GiovanniPacella/PONG_Arcade/images/pong1.jpeg

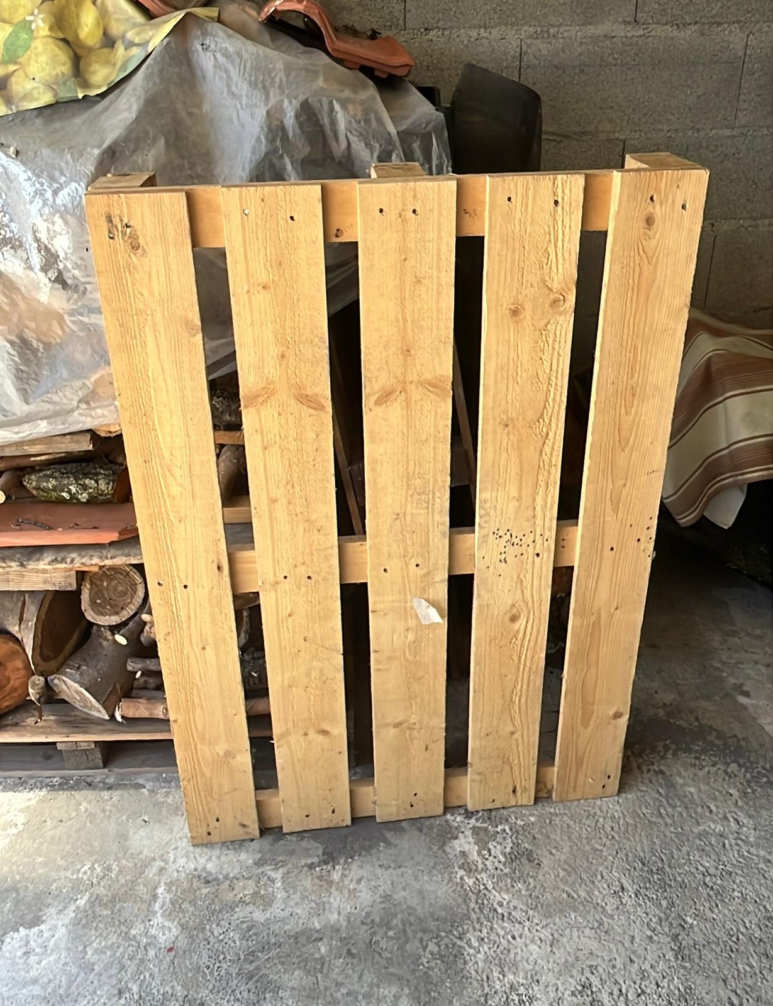
images/pong1.jpeg
