GiovanniPacella/PONG_Arcade/images/pong2.jpeg

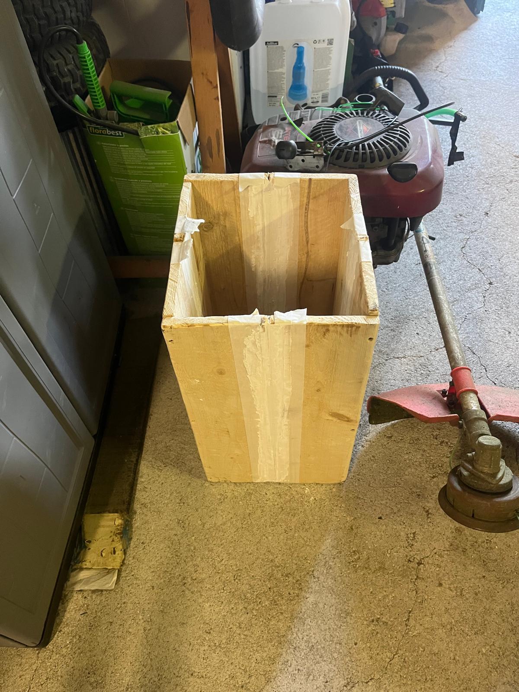
images/pong2.jpeg
