GiovanniPacella/PONG_Arcade/images/pong3.jpeg

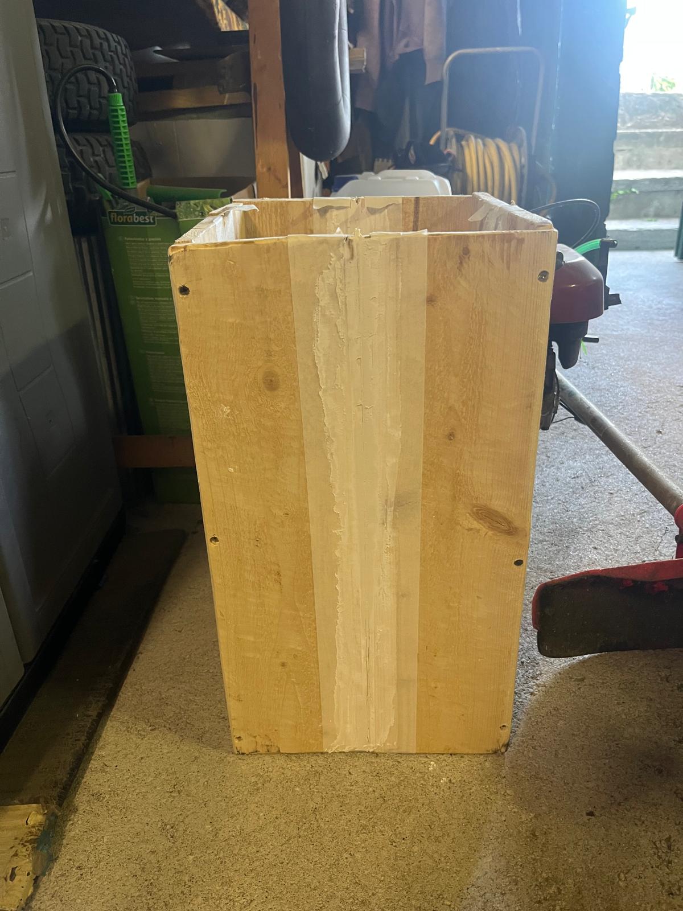
images/pong3.jpeg
