GiovanniPacella/PONG_Arcade/images/pong4.jpeg

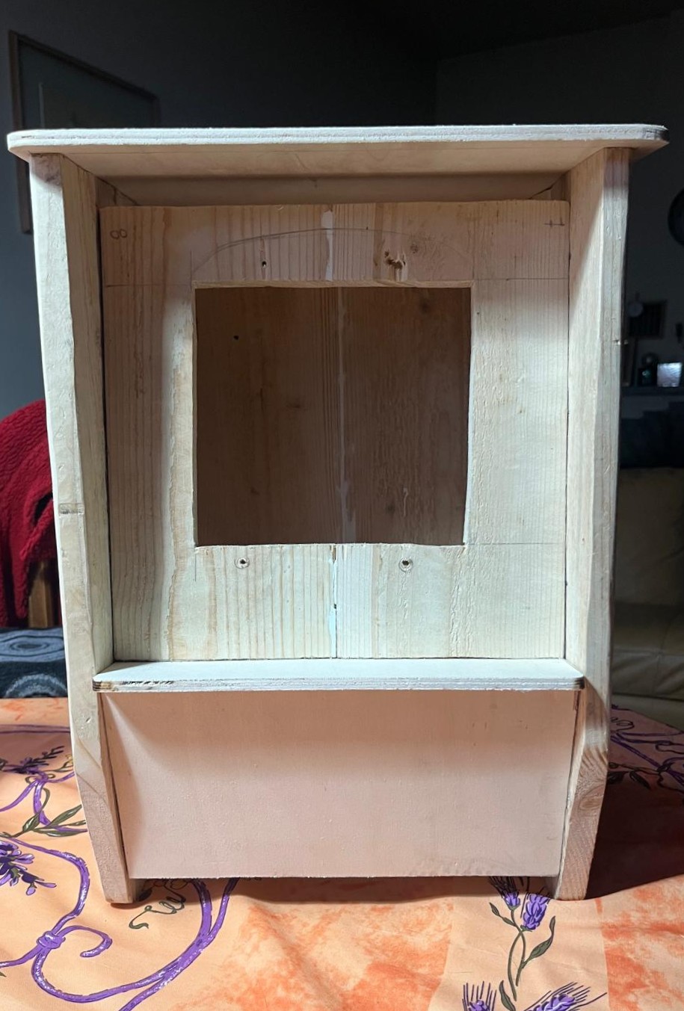
images/pong4.jpeg
