GiovanniPacella/PONG_Arcade/images/pong5.jpeg

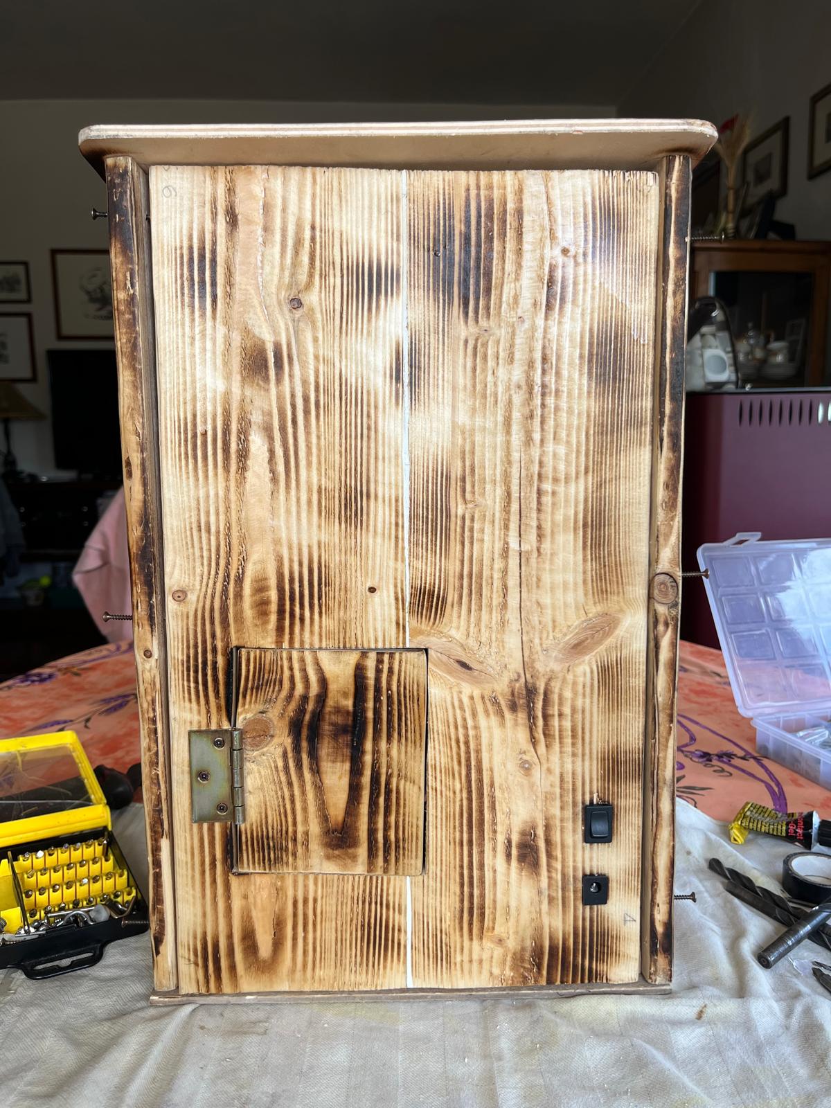
images/pong5.jpeg
