GiovanniPacella/PONG_Arcade/images/pong6.jpeg

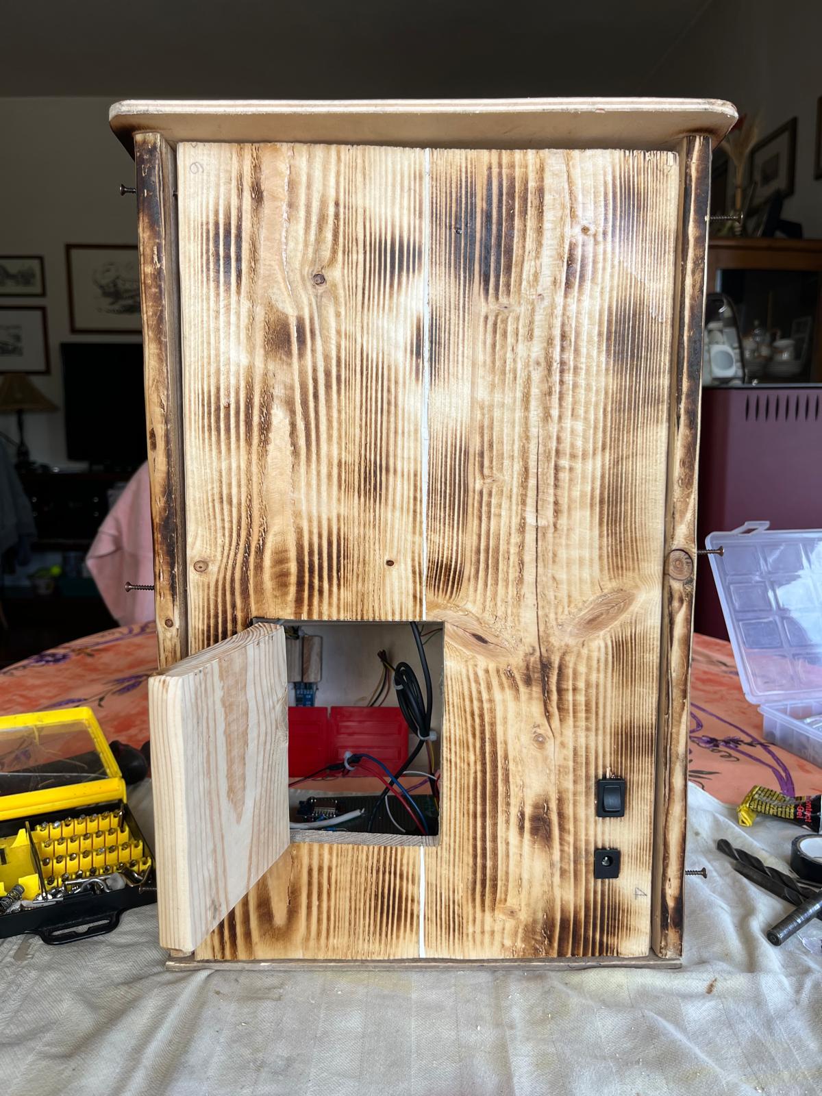
images/pong6.jpeg
