GiovanniPacella/PONG_Arcade/images/pong7.jpeg

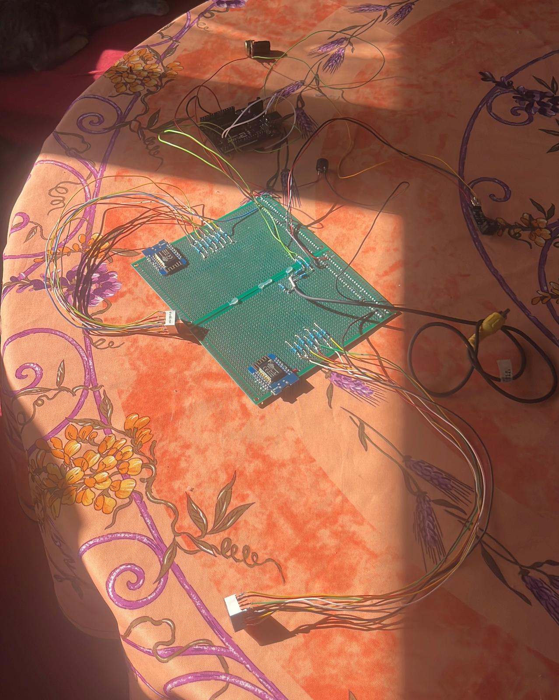
images/pong7.jpeg
