GiovanniPacella/PONG_Arcade/firmware/Comandi.h

#ifndef COMANDI_H
#define COMANDI_H

// Definizioni Comandi Seriale (UART)
#define POINT_P1 81
#define POINT_P2 82
#define RESET 84
#define POWER_OFF 85

// Limiti racchette - Player 1 & Player 2
#define MIN_PADDLE_P1 0
#define MAX_PADDLE_P1 82

#define MIN_PADDLE_P2 100
#define MAX_PADDLE_P2 182
#define OFFSET_PADDLE_P2 100

#endif
